sebras/cpu11/(commit log)

2020-07-05 vm2: cumulative fix reported by forth32
    - vector interrupt controller did not proved start address
    on unsdressed read
    - CPC was errorneosly updated after bus abort and wrong
    return address was stored after aborting Read-Modify-Write
    transactions
    - dc_b7 was too late to generate correct bra on rti to
    halt mode, the return address check for over 160000 was
    failed, no return to halt mode happened, dc_b7 now is
    promoted to br register
    Reported-by: forth32 user @ zx-pk.ru
    [de0_tb2.v, vm2_qbus.v, vm2_wb.v]
2020-07-07 wbc: fix bus moderator for slow clock emulation
    If vm_slow_clk sigNal is blinking the bus moderator might prevent
    bus from starting transaction and not set the bus wait flag, as the
    result bus hanged. Fixed for vm1, vm2, less relevant for lsi-11.
    [lsi_wb.v, vm1_wb.v, vm2_wb.v]
2020-07-24 cpu: introduce shared de0 board project
    The new directory "xen" contains the shared project for de0
    development board, the desired processor should be configured
    in the config.v file. The de0 projects in the dedicated CPU
    folders are deprecated and will be removed.
2020-07-24 cpu: introduce shared de1 project
    The new directory "xen" contains the shared project for de1
    in the config.v file. The DE1 projects in the dedicated CPU
    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
2020-07-24 cpu: introduce shared de2-115 board project
    The new directory "xen" contains the shared project for de2-115
    in the config.v file. The de2-115 projects in the dedicated CPU
    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
2020-07-24 cpu: introduce shared de10-lite board project
    The new directory "xen" contains the shared project for de10-lite
    in the config.v file. The de10-lite projects in the dedicated CPU
    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
2020-07-24 cpu: introduce shared ax309 board project
    The new directory "xen/ax309" contains the shared project for
    ax309-lite development board, the desired processor should be
    configured in the config.v file. The ax309 projects in the
    dedicated CPU folders are deprecated and will be removed.
2020-07-25 cpu: introduce shared qc5 board project
    The new directory "xen/qc5" contains the shared project for
    QMTech Cyclone V core board, the desired processor should
    be configured in the config.v file,
2020-07-25 cpu: introduce shared qc10 board project
    The new directory "xen/qc10" contains the shared project for
    QMTech Cyclone 10LP core board, the desired processor should
    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
2020-07-25 cpu: introduce shared eg4 board project
    The new directory "xen/eg4" contains the shared project for
    Sipeed Lichee Tang Risc V development board, the desired processor
    should be configured in the config.v file,
2020-10-25 cpu: add matrix analyzing application
    The matrix analyzing application provides the means
    to build microaddress tables and the sample of
    SIMD-optimized code to calculate matrix functions.
